GarrettBarton/Senior-Design-NASA-Tensile_Tester/Arduino/README.md

# Arduino Main Sketch Verions

## Overview:

 - **Version 0:** Getting examples of different sketches dealing with hardware used in the project.
  
 - **Version 1.1:** (Being written)
  
 - **Version 1.2:** (Being written)
  
 - **Version 1.3:** (Being written)
  
 - **Version 1.4:** BypassPID() is created while leaving all the PID related functions, etc.
  
 - **Version 2.0:** This version takes out the PID controls and uses stacked else-if statements and all PID related functions, etc., were removed.
