GarrettBarton/Senior-Design-NASA-Tensile_Tester/Typed_QEs/EE4820-Typed_QEs_53-67.docx

[Link to QEs 29-52] [Link to QEs 80]

QE #53 (0.00 hrs) 21Feb19 [D]

Topic: New battery order form (after re-sizing from ME testing).

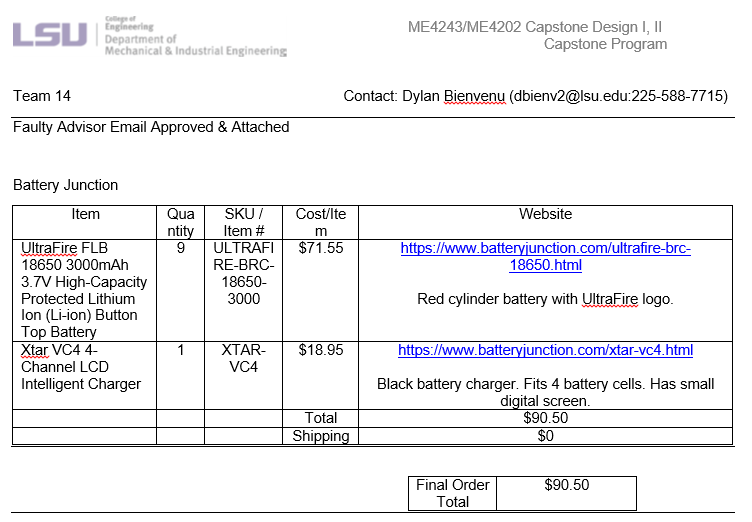
[picture p17: figure]

Outcome(s): Have new order for batteries.

QE #54 (0.50 hrs) 21Feb19

Topic: Component placement.

1. On Device:
  a. Arduino
  b. Buttons
  c. Display
  d. SD breakout
  e. Load cell amplifier
  f. Motor controller
2. On Battery Pack:
  a. Batteries
  b. Fuses
  c. Power button

On Device Item Height Width Depth Weight Arduino Buttons (each) Display SD breakout Amplifier Motor controller | On Battery Pack Item Height Width Depth Weight Batteries (each) Array Fuses (each) Array Power button

Outcome(s): Have the competents list to tell MEs where each component should go.

QE #55 (1.00 hrs) 21Feb19 [GP&A] (Whole team)

Topic: Midterm testing presentation peer reviews.

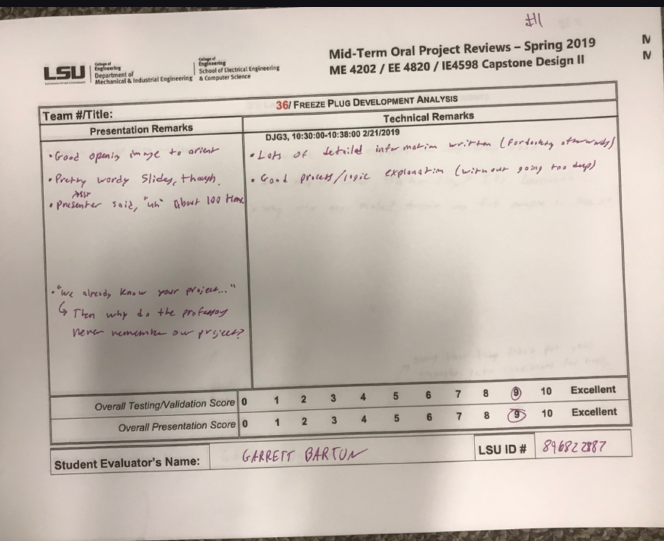
[picture p18: figure]
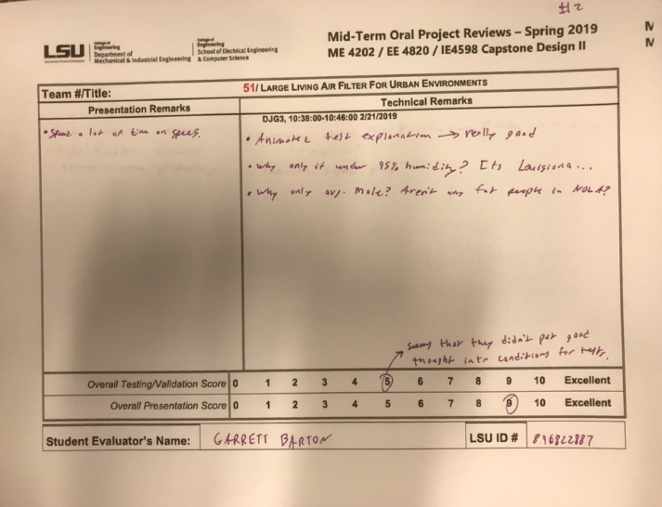
[picture p19: figure]
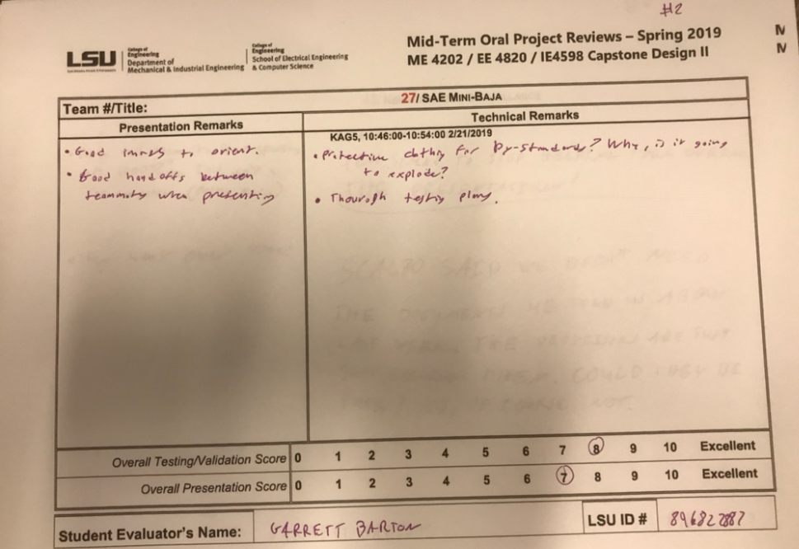
[picture p20: figure]
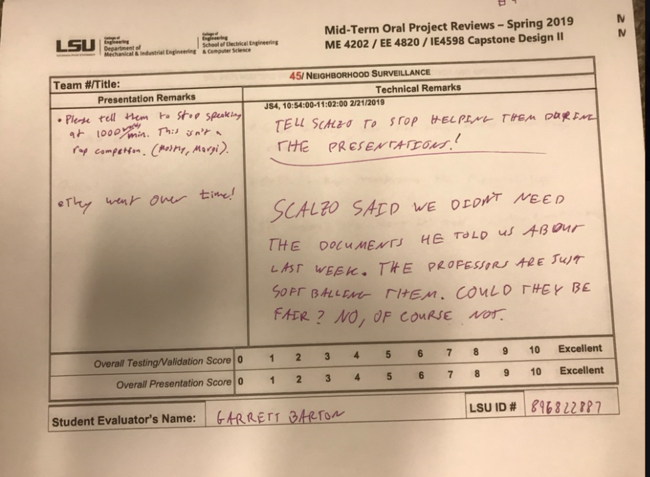
[picture p21: figure]
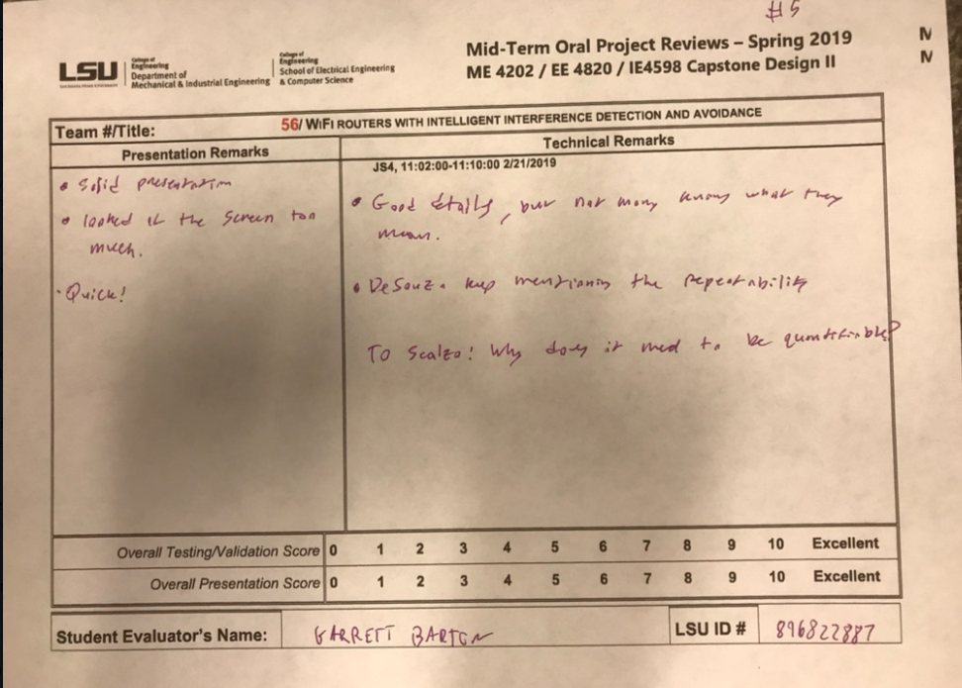
[picture p22: figure]

Outcome(s): Have documentation for watching, analyzing, and critiquing other teams’ presentations.

QE #56 (1.50 hrs) 21Feb19 [A]

Topic: Reading the forum that Ian Alexander found that has (what he called) a motor controller code (with PID) that can do everything we need.

1. (Arduino Forum (http://forum.arduino.cc/index.php?topic=8652.0)) Topic: DC motor control with PID [from “kas”]
  a. kas’s project was with a balancing robot using 2 350 RPM Pololu motors with integrated encoders (with a 14A dual motor driver). From August 2010.
  b. Codes (2 parts):
    i. First Code
      1. motorForward()…functions that are defined in main
      2. motorBackward()
      3. motorStop()
      4. Pass a PWM value [0, 255]
    ii. PID has control over the motor speeds
      1. It’s a lot, but maybe it could be made into a library or just piecemeal-ed into the code.
      2. There are a lot of functions, but they look workable and customizable.
2. Conclusion/Prescription
  a. I think that this code seems very likely to provide what this project needs and could be cleaned and serviced.
  b. Ian should figure out the pinout to suit our project and should make all appropriate changes in the code.
  c. The code comments need to be check for clarity, but seem good quality as is.
  d. Proper citation needs to be created and inserted.
  e. Citation:

Outcome(s): This code will get the motor control (with PID) that is required.

QE #57 (2.00 hrs) 23Feb19 [M]

Topic: Outlining code and fleshing out individual functions.

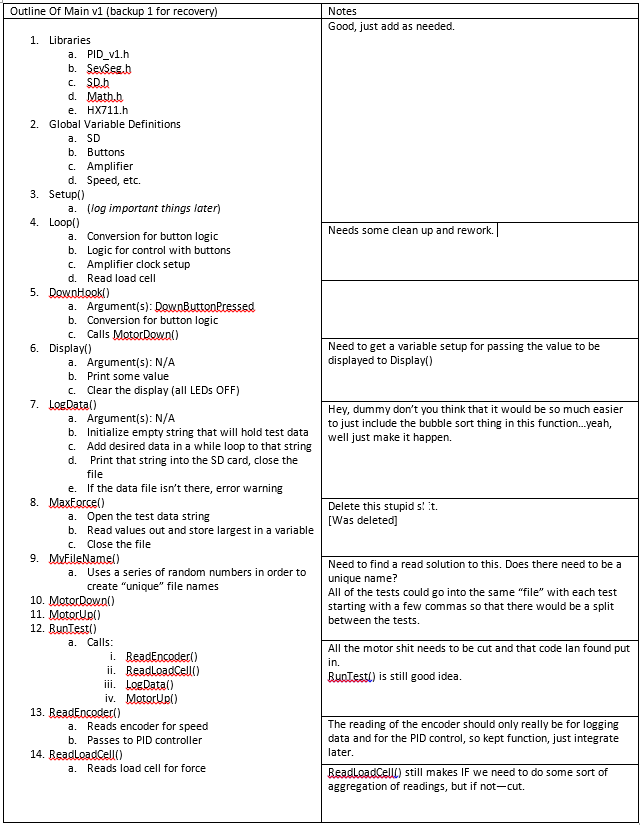
[picture p23: figure]
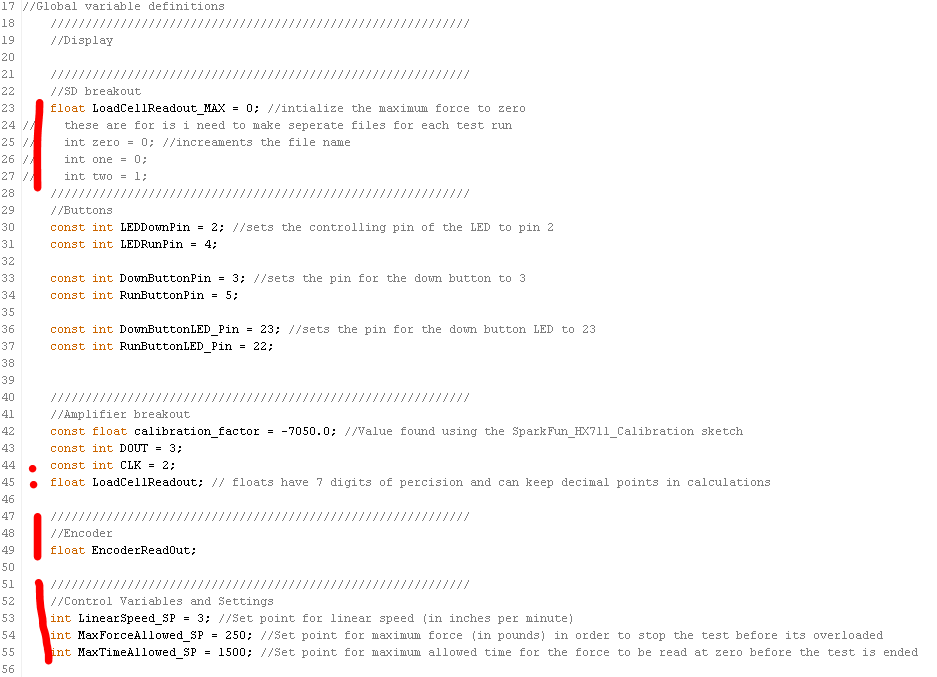
[picture p24: figure]
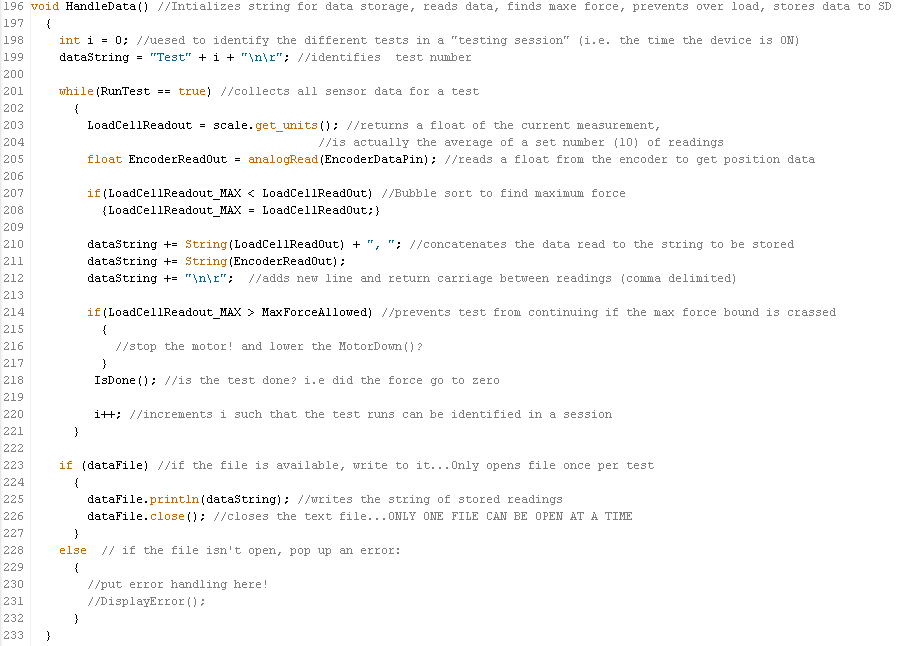
[picture p25: figure]
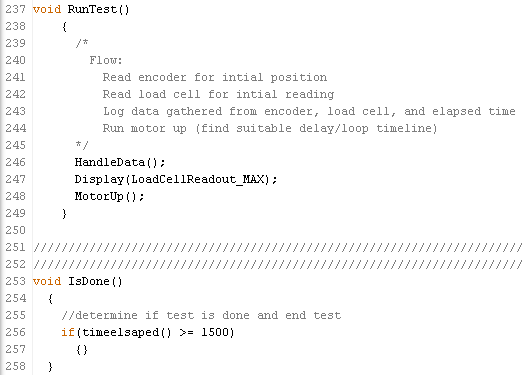
[picture p26: figure]
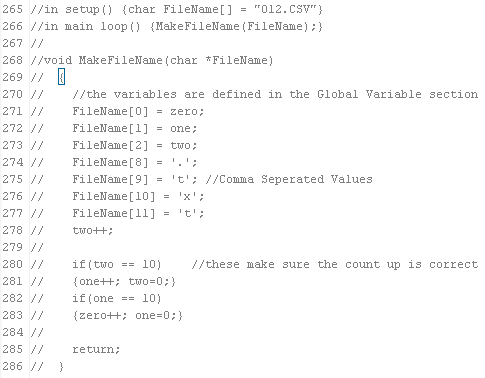
[picture p27: figure]

Outcome(s): The code is close to being ready for initial testing. Need to add: error handling and motor/PID control.

QE #58 (1.00 hrs) 24Feb19 [A]

Topic: Analyzing the code Ian found for compatibility with the present code and for how to integrate.

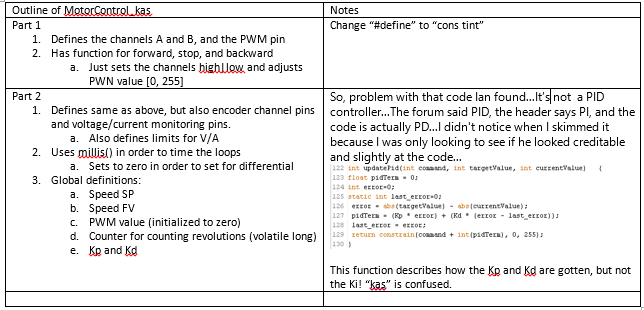
[picture p28: figure]

I had to go back and look at my control notes before I mis-identified the error.

Outcome(s): Switching back to the PID library (https://playground.arduino.cc/Code/PIDLibrary) (etc.) I found earlier (http://brettbeauregard.com/blog/2011/04/improving-the-beginner%E2%80%99s-pid-reset-windup/).

QE #59 (1.00 hrs) Feb19[A]

Topic: Analyzing the PID code I found for compatibility with the present code and for how to integrate.

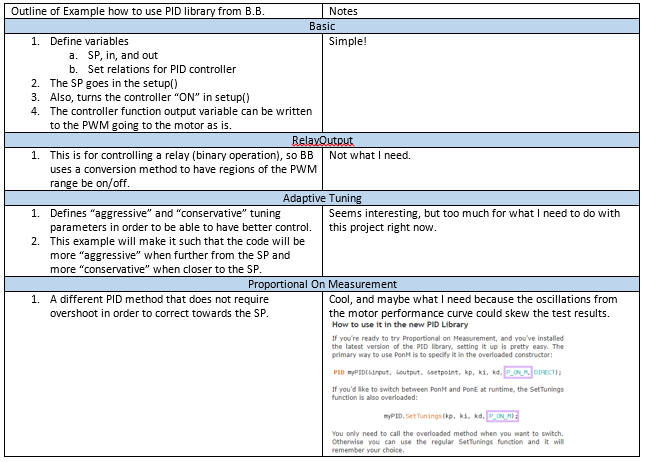
[picture p29: figure]

Outcome(s): I will be attempting to use the proportional on measure PID type control in order to help prevent overshoot.

QE #60 (1.00 hrs) 26Feb19 [GP&A] (Emily, Dylan, and Me)

Topic: Team meeting (just the MEs and myself) and working on next report due.

1. MEs doing analysis on the newest frame design.
2. MEs need to put their tests into the required document form.
3. Need foam sample from NASA, but they are ignoring us.
4. Encoder:
  a. Moved to motor…
  b. Because the LA casing can’t handle the load weight; therefore, the previous encoder placement plan wouldn’t work.
  c. The gear ratios, etc., are unknown.
5. The new casing design might require to be cut to specs if can’t bend the metal.
6. Dylan will count the gears for the ratio
7. I might need to change the buttons.
8. Making sure items to go in the device are going to fit and how the design needs to be changed.
9. Now we have to make our own attachment piece…
10. Dylan asked if the load cell would “make the load go up even though the sample piece isn’t getting pulled.” I explained how a load cell works, and Emily

Outcome(s): Got the teammates that showed up caught up and discussed issues with device to be solved.

QE #61 (1.50 hrs) 28Feb19 [GP&A] (Whole team)

Topic: Team meeting with Dr. Guo

1. Encoder
  a. DrG asked TC if he’d worked on it…TC: need to test if it works
  b. EZ: told about how shop gut suggested to move the encoder in order to support case
2. Talking about the case to hold the motor…how to create it
  a. DrG concerned about how manufacturing will affect the structural integrity
  b. IA: asking how COG will be affected…EZ: haven’t chosen material, but shouldn’t be an issue
3. DrG expressed some concern about the total length of the device (~15”)
  a. DrG: do we need all 2” of stroke
4. Buttons:
  a. EZ: explained function…DrG: can it just stay once done? YEP
5. Talked about how ours will be compared. It’s required…DrG: don’t worry about that…just talk about advantages.
  a. DrG: don’t compare the devices…WTF they said we need to compares them
  b. DrG: can’t say new tests are better than old test…you tell them we can meet the specs..
6. EZ: We (DB and/or TC) will go talk to the shop guy to see how/if what is designed can be done
7. EZ is going to work on resizing the battery case and getting models fixed up.
8. We need to re-measure all the components in order to get accurate measurements

Outcome(s): Have tasks for week(s) ahead and cleared up some component functionality.

QE #62 (1.50 hrs) 28Feb19 [A]

Topic: Outlining the library Thommy wants to use for the motor driver (https://www.pololu.com/product/2503).

1. Arduino Library (https://github.com/pololu/dual-mc33926-motor-shield)
  a. Function Definitions
    i. Setup()
      1. Baud is 115200…need to check if it will work at 9600
    ii. “void setM1Speed(int speed)”
      1. Sets Motor 1 so a speed where speed is [-400, 400]
      2. 400 corresponds to motor current flowing from M1A to M1B.
      3. -400 corresponds to motor current flowing from M1B to M1A.
    iii. “unsigned getFault()”
      1. Returns “1” if there is a motor driver fault, “0” if no fault.
    iv. “DualMC33926MotorShield(…)”
      1. Allows for custom mapping of pins
    v. “void init()”
      1. “Initialize pinModes and maybe timer1.”
2. User’s Guide (https://www.pololu.com/docs/0J55/all)
  a. Dual motor driver
  b. FET for battery protection
  c. Stackable on the Arduino
  d. Logic inputs are 5 | 3.3 V

Arduino Pin | Shield Pin Name | Basic Function
Digital 4 | D2 (or nD2) | Tri-state disables both outputs of both motor channels when LOW; toggling resets latched driver fault condition
Digital 7 | M1DIR | Motor 1 direction input
Digital 8 | M2DIR | Motor 2 direction input
Digital 9 | M1PWM | Motor 1 speed input
Digital 10 | M2PWM | Motor 2 speed input
Digital 12 | SF (or nSF) | Status flag indicator (LOW indicates fault)
Analog 0 | M1FB | Motor 1 current sense output (approx. 525 mV/A)
Analog 1 | M2FB | Motor 2 current sense output (approx. 525 mV/A)

  e. Between 5-8V degrades motor controller performance and max current output
  f. Max continuous current rating of 5A
    i. Will reduce current automatically if over or if temp reaches limit
    ii. They tested at room temp (no forced air + 100 =d): max, lasted 10 s; 4A, 37 s; 3A, 10 min.
    iii. They suggest to add cap(s) in order to reduce noise.
  g. Simplified Motor Control Truth Table

Inputs | | | Outputs
D2 | MxPWM | MxDIR | MxA | MxB | SF | Mode
H | H | L | H | L | H | forward
H | H | H | L | H | H | reverse
H | L | X | L | L | H | brake
L | X | X | Z | Z | L | coast

L = LOW, H = HIGH, X = HIGH or LOW, Z = high impedance

  h. Customizing the Shield

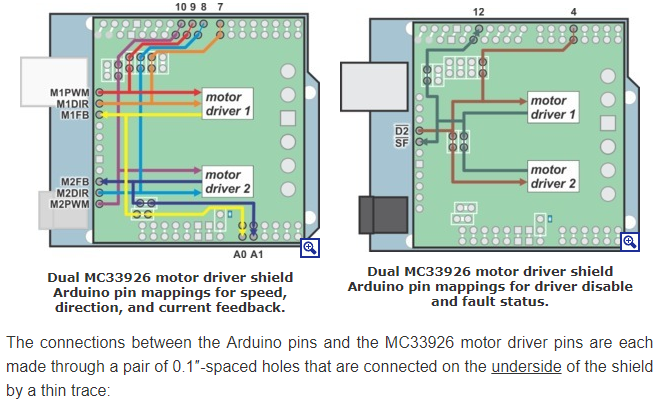
[picture p30: figure]
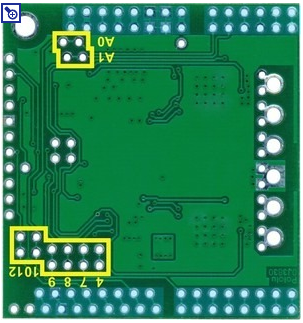
[picture p31: figure]

    iii. The yellow boxes would need their trace cut if any custom mapping is to occur.

Outcome(s): Have clear idea of how to work the library and how the board operates.

QE #63 (2.00 hrs) 28Feb19 [M]

Topic: Adding code for motor controller and integrating PID controls.

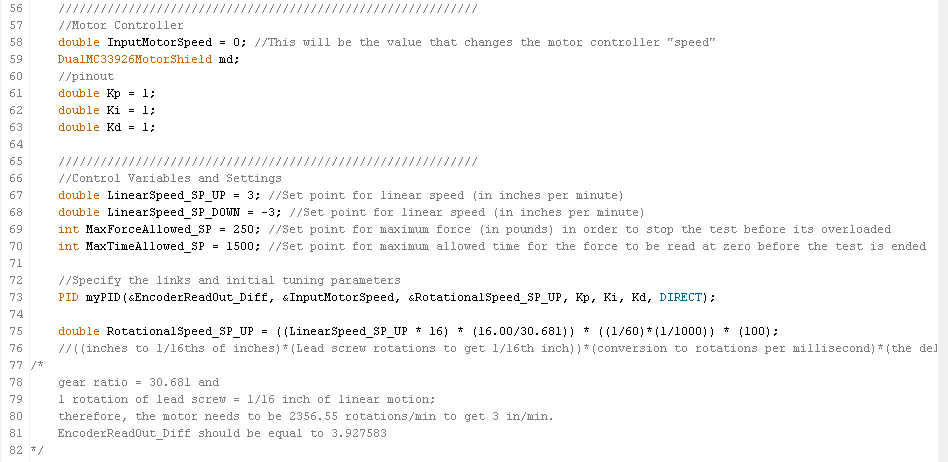
[picture p32: figure]
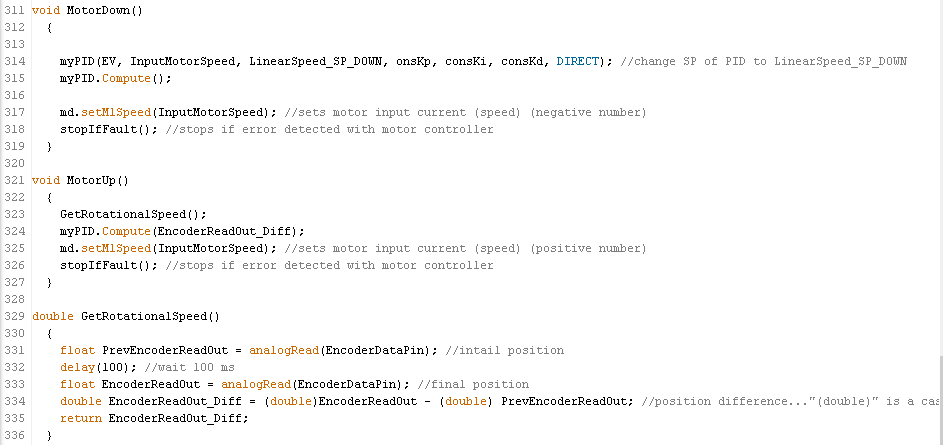
[picture p33: figure]

| 1. I did my best to setup the PID, but I need Thommy to confirm how the encoder will output to determine how the input to the encoder will work. 2. Need to go throw and count the added delay() functions because otherwise the code will take too long.

Outcome(s): Have the PID integrated (or started to) and I now have a method of capturing an input for the PID from the encoder.

QE #64 (1.00 hrs) 28Feb19 [A]

Topic: Calculating the gear ration and figuring the rotational motion of motor to equivalent linear motion of the hook assembly.

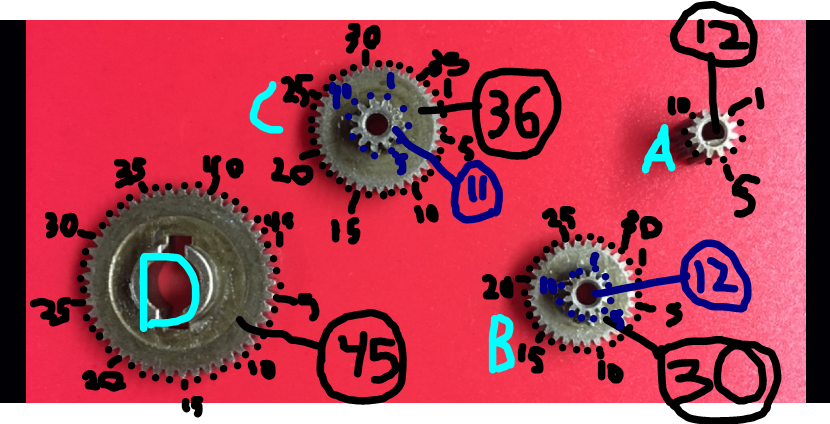
[picture p34: figure]
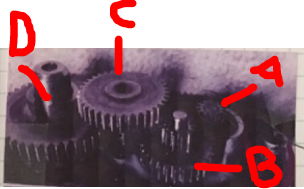
[picture p35: figure]

Gears separated | Gears assembled in housing

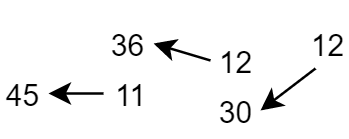
[picture p36: figure]

1. Counting the number of teeth on each gear yielded:
  a. A: 12
  b. B: 12 and 30
  c. C: 11 and 36
  d. D: 45
2. Total Gear Ratio (https://woodgears.ca/gear/ratio.html) with compound gears:
  a. Gear Ratio=(Driven Gear Teeth)/(Drive Gear Teeth)
  b. (30/12)(36/12)(45/11)=(30*36*45)/(12*12*11)=30.681
3. Conversion to linear motion
  a. 1 rotation of lead screw is 1/16th of inch linear
  b. 1 rotation of motor=(1/30.681)= 0.3259 rotations of lead screw
  c. 1 rotation of motor=(1/30.681)1/16= 0.00204 inches of linear motion
  d. # rotations of motor to get 1/16 inch of linear motion=30.681 motor rotations
  e. # rotations of motor to get 1 inch of linear motion=(30.681)16=490.0 motor rotations
  f. # rotations of motor to get 2 inches of linear motion=(30.681)32=981.81 motor rotations
  g. # rotations of motor to get 3 inches of linear motion=(30.681)48=1472.72 motor rotations
4. For code:
  a. Inputs linear set point in inches
  b. Outputs rotational speed in rotations
  c. Need to check if the speed of motor is 2356.55 (rotations)/(minute) (3 (inches)/(minute) )
  d. Using a delay(): 1472.73(rot)/(min)=(1472.73 rot)/(1 min)x(1 min)/(60 s)x(1 s)/(10^3 ms)=0.0245455 (rot)/(ms) ∴ 100 ms≅2.45455 rotations⇒2 rotations

Outcome(s): Have the gear ratio and a conversion from rotational motion of the motor to linear motion of the hook assembly.

QE #65 (0.50 hrs) 28Feb19 [T]

Topic: Creating test plans and documentation for the battery charger test.

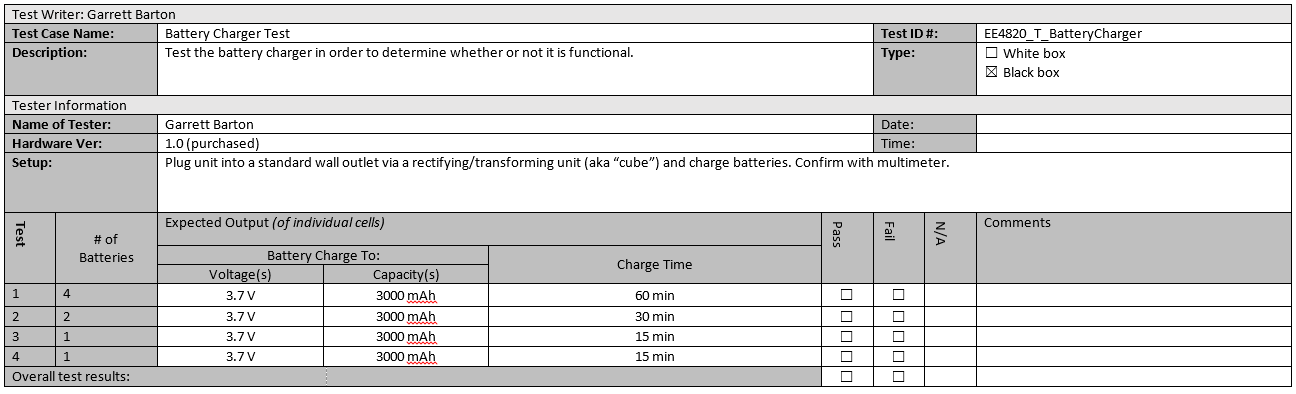
[picture p37: figure]

Outcome(s): Have required documentation format for the battery charger test.

QE #66 (7.50 hrs) 28Feb19 [T]

Topic: Testing the battery charger for functionality and timing.

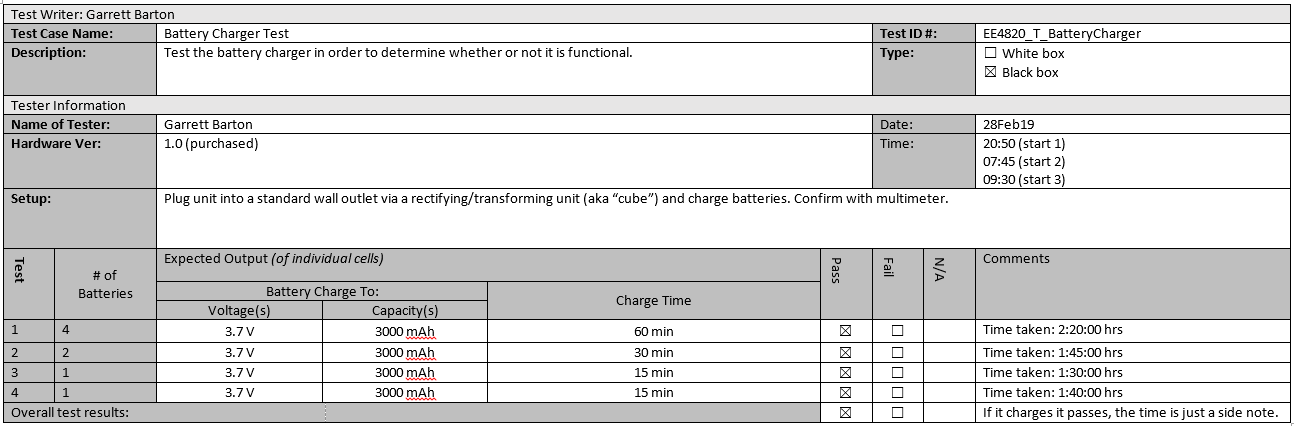
[picture p38: figure]

Outcome(s): Battery charger works, but it does take longer than I expected/hoped.

QE #67 (0.00 hrs) 06Mar19

Topic: BTB #3.

Outcome(s): Have documentation for BTB #3.
